zxc2012/NXP_Creative/README.md

### 智能车竞赛软件&&硬件开源
纪念那些ctrl+c/v的日子

quridor框架：minimax+alpha-beta prouning(java)

控制:双K60FX
