zxc2012/NXP_Creative/F题 纸张计数显示装置 余晨阳 田泽豪 王宇丰.pdf

# 全国大学生电子设计竞赛设计报告

## 选 题： F 题 纸张计数显示装置

摘要

本系统以 STM32F407 单片机为控制核心，结合电容传感器检测电路、显示电路、键盘

输入电路和蜂鸣器电路，实现了对两极板间的纸张数量进行计数并显示的功能。主控单元

通过 IIC 接口循环读取 FDC2214 的转换值；键盘输入电路将实时数据存储到单片机中，

利用最小二乘法拟合曲线，然后通过比较来检测当前的纸张数。经过实验与调试，系统成

功实现了题目所有的要求，且训练时间短，自适应能力强。整个装置采用直线滑轨结构，

稳定性好、精度高、功耗低，具有较高的性能指标。
关键词：STM32 单片机；FDC2214 传感器；最小二乘法；直线滑轨结构

## 1 方案分析与比较

## 1.1 主控芯片的选择

方案一：使用 8 位的 STC89C52 单片机，操作简单，使用方便，但中断资源较少，时

钟频率较低，处理速度较慢，实时性不高。

方案二：采用 32 位的 STM32F407 单片机作为控制芯片，芯片时钟频率高达 168MHz，

处理运算能力较强，且外设资源十分丰富。

综合考虑以上方案，由于本系统需要快速测量出电容，并计算出纸张数目，此过程中

涉及较多浮点运算，所以对单片机实时性和浮点运算能力有较高要求，此外单片机需要具

有 I2C 接口来连接 FDC2214 模块，还要使用 SPI 接口来连接显示模块，STM32F407 单片

机的资源更加丰富，故选择方案二。

## 1.2 测量传感器模块选择

方案一：NXP 公司生产的 PCA8885 电容式传感器。两极板间距离的变化带来电容的

变化，然后传感器将其转变为电信号。它具有自校准功能，性能受污垢、湿度等因素影响

较小。

方案二：TI 公司生产的 FDC2214 电容式传感器。FDC2214 分辨率高达 28 位，它还

具有多通道抗噪且抗 EMI 的特点。另外，TI 公司的 FDC2214 设计资源相当丰富，价格实

惠。

方案三：电涡流传感器。它通过电涡流效应的原理，准确测量被测体与探头端面的相

对位置，其特点是长期工作可靠性好、灵敏度高、抗干扰能力强。但是价格昂贵，且多面

向工业应用。

上述三种传感器均有较高的精度，可达到题目的要求，但是考虑到 FDC2214 芯片使用

更加方便，成本更低，所以最终采用方案二。

## 1.3 显示模块的选择

方案一：采用 LED 数码管显示。数码管使用简单，价格低廉，但一个数码管只能显

示一个数字，要显示多位数据时要使用多个数码管及译码器，增加了硬件电路的复杂度和

额外功耗，而且 LED 数码管也无法显示复杂字符，而本题需要展示相应的手势图片，所

以 LED 数码管不宜选用。

方案二：采用 OLED 液晶屏显示。OLED 重量轻，抗震性能好，响应时间短，显示

画面无拖影现象，显示内容丰富，驱动程序简单，可以实时显示文字及数据。

由于测试时需要自适应和功能切换等多个功能，采用 OLED 液晶屏显示能够更直观方

便，且便于调整，故选择方案二。

## 1.4 系统总体方案设计

本系统需要具备三个部分：数据采集部分、数据处理部分和输出部分。数据处理部分

选用 STM32 单片机作为主控芯片，来实现对各个其他模块的控制；数据采集部分选用

FDC2214 电容传感器模块，通过检测电容变化来判断纸张的数量；输出部分则采用显示模

块显示系统各个参数值以及纸张的数量。此外，通过按键来进行数据的确认和调整，通过

蜂鸣器来标志数据的存入。系统的总体方案原理图如图 1.1 所示。

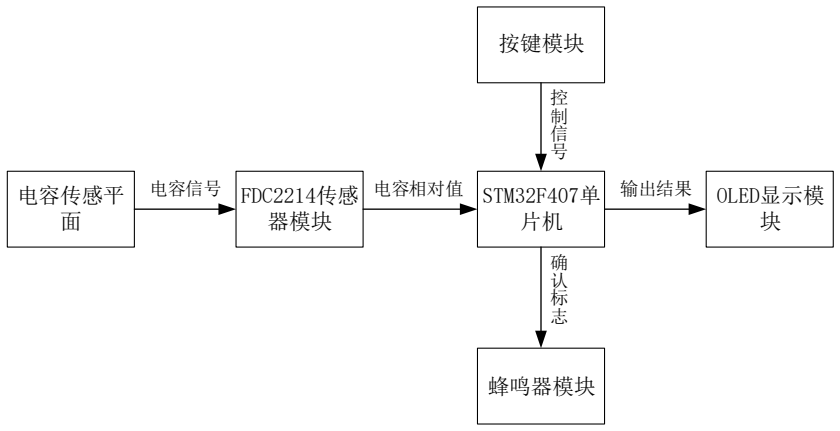
[picture p5: figure]
电容传感平 面; FDC2214传感 器模块; STM32F407单 片机; OLED显示模 块; 按键模块; 蜂鸣器模块; 电容信号; 电容相对值; 输出结果

图 1.1 系统总体框图

## 2 理论分析与计算

## 2.1 测量原理分析与计算

本系统采用 TI 公司出产的 FDC2214 电容传感器测量电容值，根据该电容值以及电容

定义式，即可得出两极板之间距离。传感器所得参数为
sensor

f

，即电容极板和电感所组成的

LC 谐振回路的谐振频率。根据 FDC2214 数据手册，可得：

28 2
sensor
x
REFx

f
DATA
f

·
=
(2.1)

其中 DATAx 为第 x 通道传感器读数，
sensor

f

为电容极板和电感所组成的 LC 谐振回路
的谐振频率，有：

1
2

sensor

f
π LC

=
(2.2)

其中，L 为电路中的固定电感，C 为总电容。

设 C0 为 FDC2214 电容传感器上的固定电容，CX为极板间的电容。根据式 2.1、2.2，

可以得出极板电容为：

56

0 | 0 2 | 2 | 2

2
4

X
x | REFx
C | C C | C
π L DATA | f
= - | = | -
× | ·
(2.3)

由电容定义式

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
(2.4)

可得出极板间距 d 与传感器读数之间的关系为：

| | 2 | 2
0
56 | 2 | 2 | 2
0
(2 | 4 | )
r | x | REFx
x | REFx
S L DATA | f d
k | L DATA | f | C

ε ε π
π
| | | | × | | | | ×
=
- | × | × | ×
(2.5)

根据式(2.5)可以看出，在其它变量保持一定时，极板间电容的大小 C 与极板间距 d 程 反比关系。若将电容值取倒数，可得厚度函数
| | | | f

与纸张数成正相关关系。

## 2.2 误差分析与抗干扰分析

对给定数据点集合{(Xi ,yi)}(i=0,1,2,…,m)，在取定的函数类 φ

中，求
p(X)Îφ

，使误差

的平方和

2 E
最小，有：
2 | 2 [ ( | ) | ] E | p X | y = | - ∑ | i | i
(2.6)

我们利用 SPSS 软件对电容的倒数(厚度函数)进行回归分析，得到拟合曲线结果和相关

系数结果如图 2.1 和表 2.1 所示。

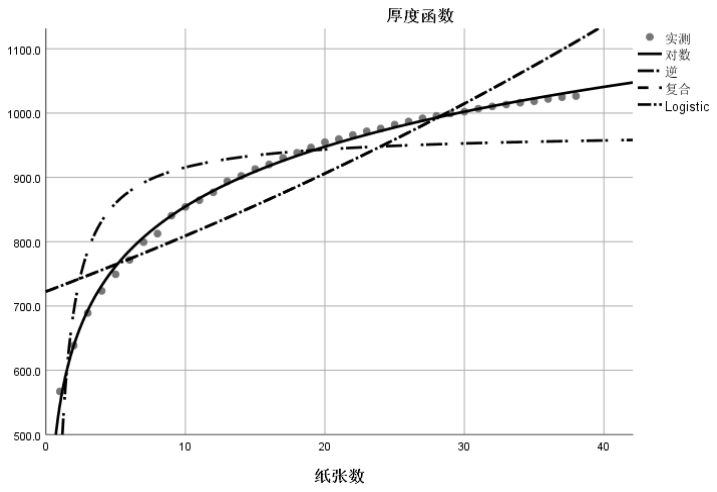
[picture p6: figure]

图 2.1 电容值的倒数随纸张变化曲线拟合图像

表 2.1 四种函数拟合统计分析结果

函数类型 | 2 R | F
对数 | 0.997 | 11401.412
逆 | 0.706 | 86.522
复合 | 0.780 | 127.600
S | 0.775 | 124.040

由图 2.1 和表 2.1 可知，对数函数拟合我们的厚度函数效果最好，回归参数

2 R
可达

0.997。

对于本系统的抗干扰性，系统受到的干扰来源于机械结构的松动造成的极板正对面积

的变化以及外界信号干扰造成的电容测量变化。对于机械松动，可以使用滑轨与滑块作为

极板的活动支撑，由于滑轨可以约束滑块只朝平行于导轨方向运动，可以在很大程度上防

止极板左右移动，保证了正对面积的恒定。对于外界信号干扰，可在极板到传感器的连接

上使用 SMA 线，并对采集到的原始数据进行限幅平滑滤波，以减小误差、提高抗干扰性。

## 3 硬件及程序设计

## 3.1 电路设计

MCU 外围电路包括复位电路、JTAG 调试电路、时钟电路等等。具体电路见附录 2。

测量传感器电路主要由四通道 FDC2214 电容传感器芯片，外部 40M 有源晶振电路，

抗 EMI 电磁干扰电路组成。其中 FDC2214 芯片通过 I

2C 接口与 STM32 单片机通信实现

FDC2214 寄存器配置以及 STM32 数据读取。将两极板分别接上 FDC2214 模块一个通道的

两个端口上连上极板的两个端口。此外，为了防止感应板与 FDC2214 芯片的引线过长产生

EMI，电路中设计了抗电磁干扰电路，提高了系统稳定性。

## 3.2 机械结构设计

本设计的机械结构是以滑轨和滑块为主体搭建的。其中最上方和最下方的滑块为固定

滑块，用来代表移动边界，中间的滑块为移动滑块，且与滑轨连接光滑。两极板分别固定

在中间滑块和下方滑块上，纸张放置在极板之间，这样将中间滑块与下方滑块贴合就可以

测量纸张的数目了。此外我们设计了一个底座来固定滑块和滑轨，使系统具有更高的稳定

性和抗干扰性。

此机械结构能够保证两极板间接触面积恒定，且能够保证与纸张完全压紧，更换纸张

数目也很简便，具有较高可行性和精确性。系统机械结构如图 3.1 所示。

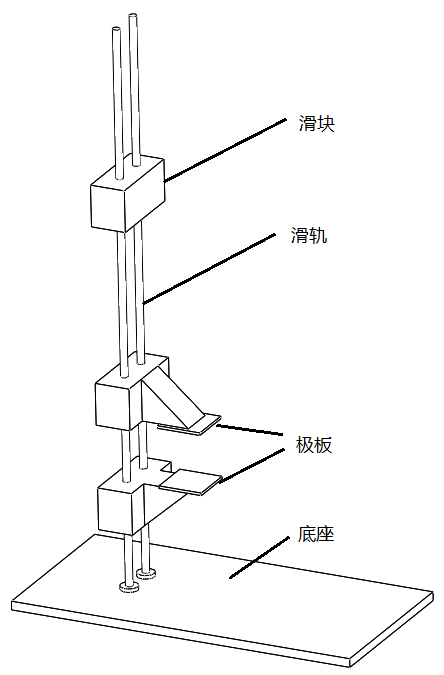
[picture p7: figure]

图 3.1 系统机械结构设计图

## 3.3 软件设计

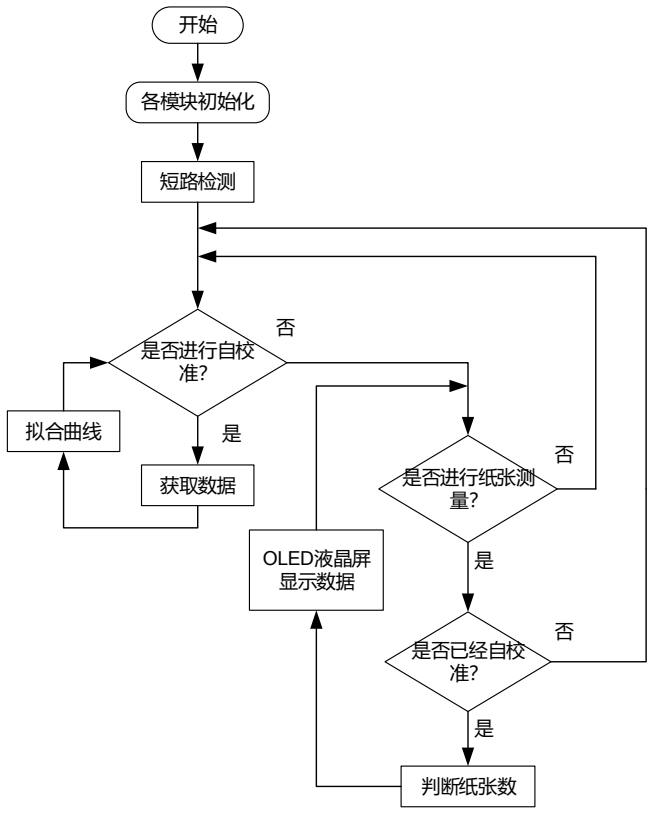
[picture p8: figure]
各模块初始化; 是否进行自校 准？; 短路检测; 获取数据; 拟合曲线; 是否进行纸张测 量？; 是否已经自校 准？; 判断纸张数; OLED液晶屏 显示数据

图 A 主程序框图 | 图 B 学习模式框图

图 3.2 系统运行整体流程

系统程序框图如图 3.2 所示，分别为系统主程序与学习子程序。系统初始化后，首先 初始化各个模块，随后判断极板的短路情况，然后选择功能。若进入自校准模式，则采集 多组数据进行拟合，得到纸张数目随传感器测量值的变化曲线，然后返回到任务选择部分。 如果再选择测量纸张模式，则首先会判断是否已自校准，如果已经校准，则利用计算的拟 合曲线对传感器输入量进行判定，得出纸张数量，如果还没有校准，就不进入测量模式， 而是继续选择任务。

其中在学习模式下，首先抽取不同数量的纸张，在单片机中存储不同数量纸张对应的

测量值，对该值进行函数拟合，即可得到一条纸张数与测量值之间的函数曲线。由于误差

的存在，计算出的纸张数通常为小数，此时可以将该值分别向上和向下取整，比较测量值

与两个计算出的值的接近程度，选择更接近的传感器数值对应的纸张数目，即可判定纸张

数目。

## 4 测试数据与结果分析

（1）基础部分：

经过测试，该系统能够存储不同纸张对应的测量数据，并计算出拟合函数的待定系数，

具有自校准功能。且在两极板短路时会产生提示，具有短路自检功能。

在纸张数目为 1~10 中任意抽取几组数据进行测试，得到结果如表 4.1 所示。

表 4.1 纸张数为 1 至 10 张时测试记录表

次数 | 实际数目 N0 | 测量数目 N | 数目偏差|N-N0| | 测量时间 t/s
1 | 1 | 1 | 0 | 0.04
2 | 4 | 4 | 0 | 0.04
3 | 5 | 5 | 0 | 0.01
4 | 9 | 9 | 0 | 0.05
5 | 10 | 10 | 0 | 0.03
从表中可以看出，当纸张数目为 1~10 时，该系统能够精准的测出极板间纸张的数目，

且用时较少，满足题目要求。

（2）发挥部分：

在纸张数目为 15~30 和 30 以上中任意抽取几组数据进行测试，得到结果如表 4.2 所

示。

表 4.2 纸张数目为 15 至 30 和 30 以上时测试记录表

次 数 | 纸张数为 15 至 30 张 | 纸张数大于 30 张
实际数目 | 测量数目 | 测量时间 t/s | 实际数目 | 测量数目 | 测量时间 t/s
1 | 15 | 15 | 0.03 | 30 | 30 | 0.03
2 | 18 | 18 | 0.03 | 33 | 33 | 0.03
3 | 20 | 20 | 0.01 | 35 | 35 | 0.01
4 | 24 | 24 | 0.06 | 38 | 38 | 0.06
5 | 28 | 28 | 0.02 | 40 | 40 | 0.02
6 | 30 | 30 | 0.05 | 41 | 40 | 0.05
从表中可以看出，当纸张数目为 15~30 时，该系统能够精准的测出极板间纸张的数目，

且用时较少，满足题目要求。

当纸张数目为 30~40 时，该系统能够精准的测出极板间纸张的数目，且用时较少，满

足题目要求。但当纸张数目大于 40 后，系统无法正确测量出纸张的数目。

通过上述测试结果，可以看出，该系统能够精确测试出纸张数目为 1~40 时的纸张数

量，且用时较短，满足题目的全部基本要求和发挥部分的第一问。发挥部分第二问中，当

纸张数目过大时，受电容传感器分辨率的影响，而此时的电容值非常接近，故测量出现一

定偏差。综合测试结果，该系统纸张数目最多可以测量到 40 张，且具有自校验和检测短路

的功能。

5 小结

通过系统测试，本系统成功实现了纸张计数的功能。在通过自校准后，可以快速稳定 识别 38 张以内的纸张数目，并可以蜂鸣提示及在 OLED 屏幕中显示，实现了题目中的基 本要求和发挥要求。同时，在识别过程中，还可实时检测极板短路情况，并给出提示。在 测量纸张数大于 35 张时，发现传感器数据间隔越来越小，分辨力降低。但是我们采用加固 机械结构、使用屏蔽线等措施，大大提高了信噪比，使得在纸张数较多时，仍然能够分辨， 减少了误判的可能性。在比赛中，我们遇到了很多困难，但是最终我们解决了各种问题， 成功实现了题目的各项要求。

## 附录：各模块电路图

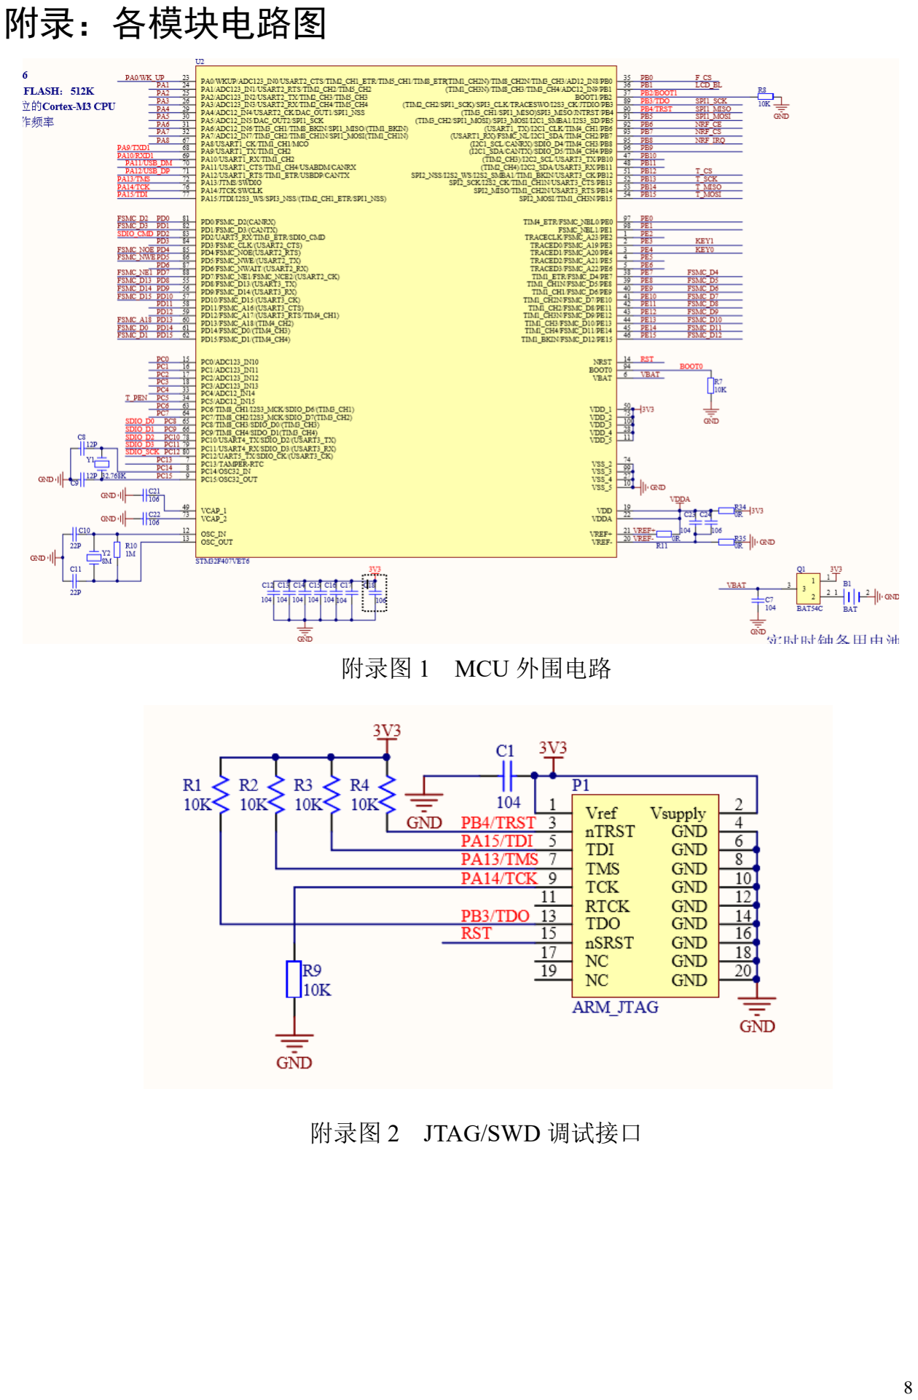
[picture p9: page 10]

附录图 1 MCU 外围电路

附录图 2 JTAG/SWD 调试接口

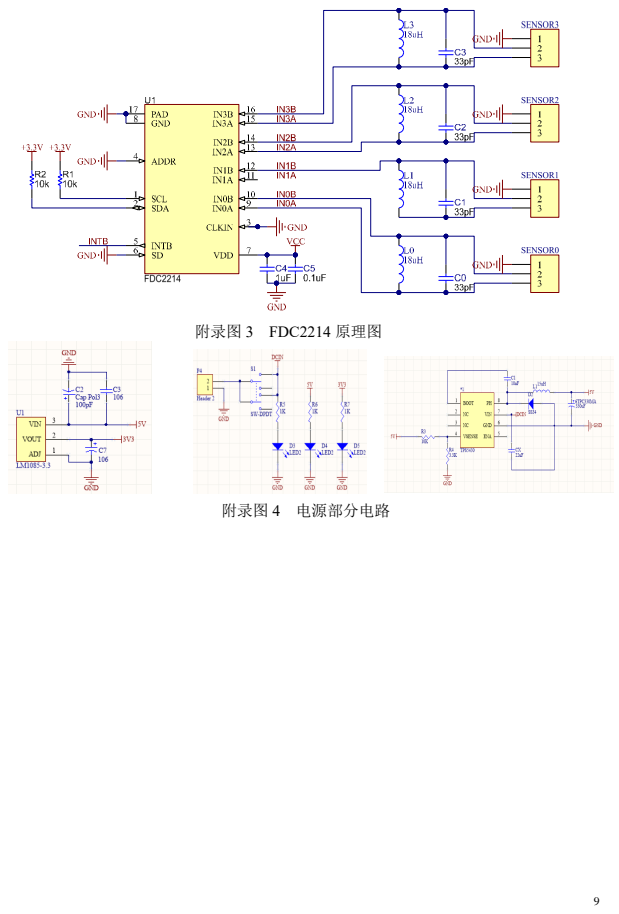
[picture p10: page 11]
附录图 3 FDC2214 原理图; 附录图 4 电源部分电路
