zxc2012/NXP_Creative/Cylinder/readme.md

# 要求

- 随机生成函数RandomArray（int n, int max）:随机生成一个一维整数数组，数组长度为n，元素值不超过max
- 判断函数CheckOrder（）：判断数组中元素是否按升序排练，若是返回1，否返回0
- 数组和函数Sum（）：计算数组和
- 判断某个元素函数CheckKey（）：找到数组中的某个值（key），若有返回1，无返回0
- 编写main函数，调用测试以上功能
