zxc2012/NXP_Creative/参赛承诺书.pdf

# 第十四届全国大学生“恩智浦”杯 智能汽车竞赛参赛承诺书

我们参加第十四届全国大学生“恩智浦”杯智能汽车竞赛，通过报名获得参

赛资格，同意并承诺：

1. 阅读、理解并接受第 14 届全国大学生“恩智浦”杯智能汽车竞赛比赛规则；
2. 遵守组委会制定的规章制度，按照组委会要求提供详细，准确的报名信息；

独立完成赛车设计、开发、调试工作，并接受组委会检查；

3. 按照规定提交符合规范的设计技术文档；同意竞赛秘书处和恩智浦公司在其

相关主页及文献中收录并公开获奖作品的设计方案、技术报告及参赛模型车

的视频、图像资料；

4. 按时参加比赛；参赛过程中，我们承诺遵守大赛规则、公平竞争。
5. 承诺在比赛期间言行、举止文明合法，注意交通安全、不到任何公共水域游

泳，对自己的人身安全负责。

大学名称： 武汉理工大学

(盖章)

参赛队伍名称： 996.icu

带队教师代表签字：

队员签字：

日期：
