zxc2012/NXP_Creative/硬件/RT1062/原理图.pdf

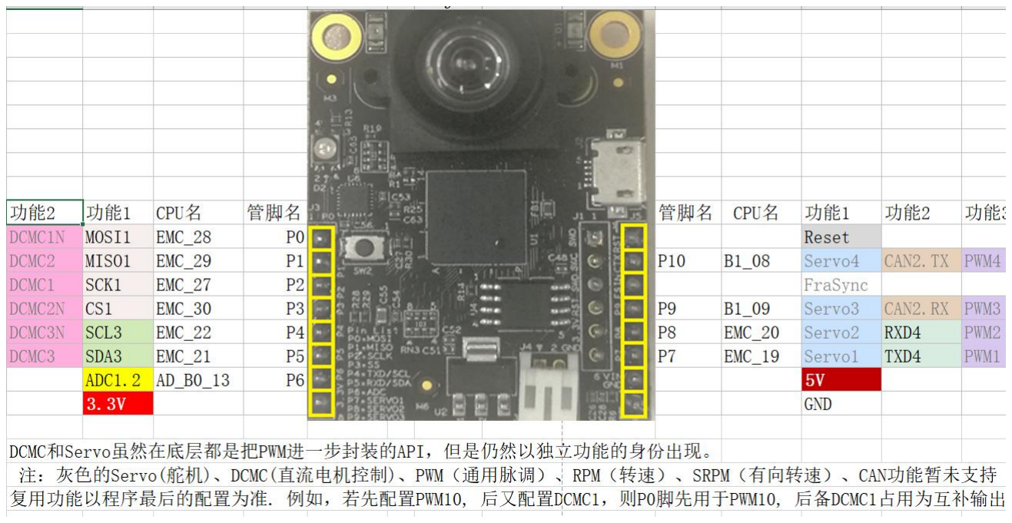
[picture p54: figure]
