zxc2012/NXP_Creative/硬件/Control board/八路btn驱动.pdf

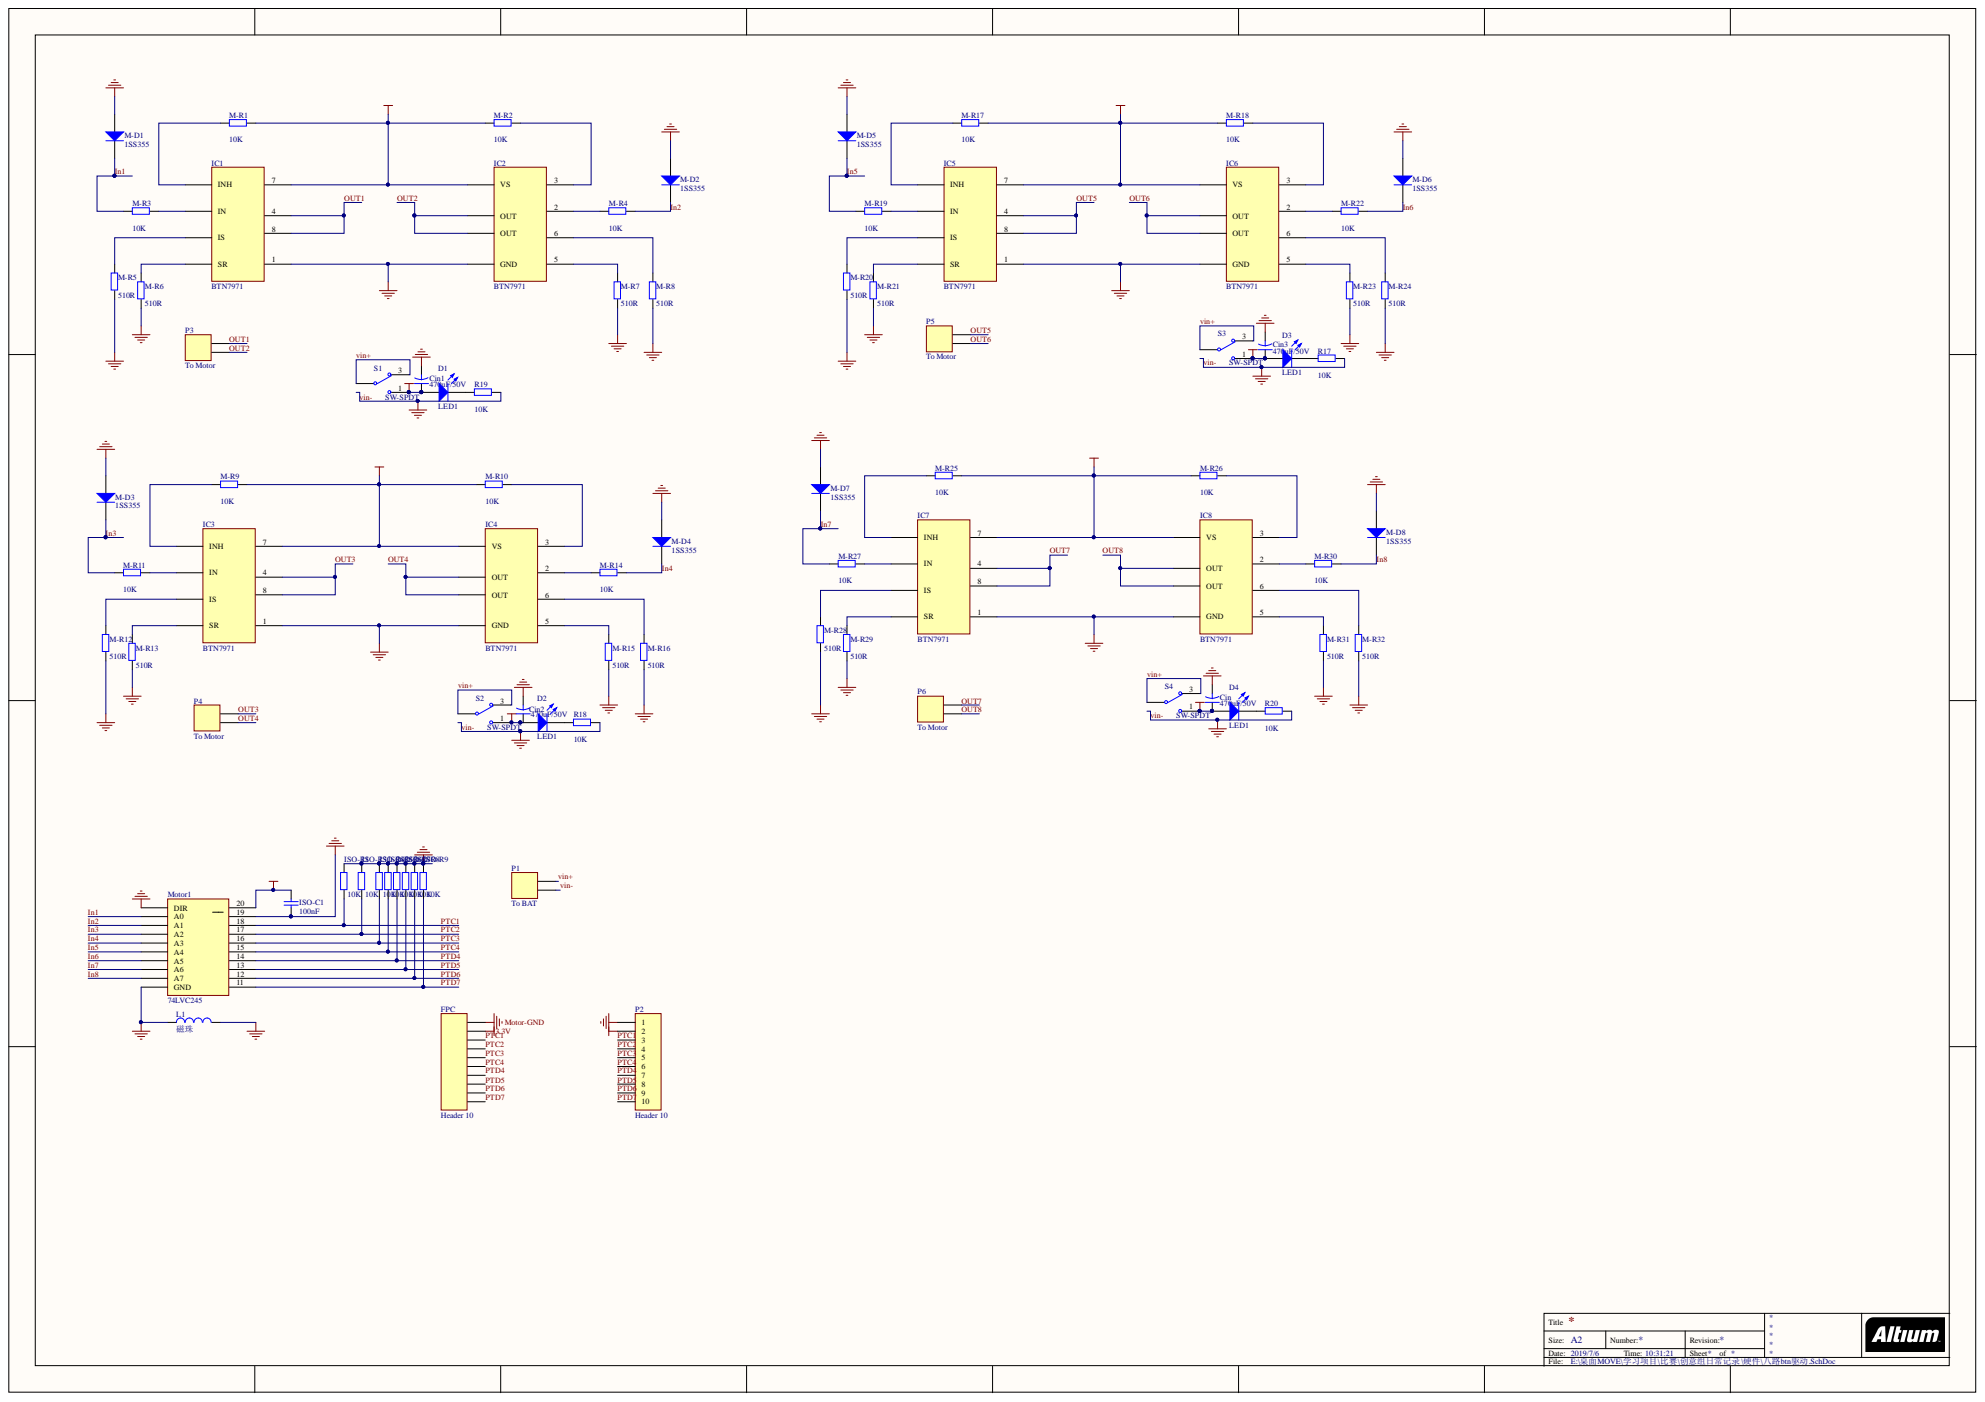
[picture p55: page 1]

SW-SPDT Motor-GND

* Title | * * * * *

Size: A2 | Number: * | Revision: *

Date: 2019/7/6 Time: 10:31:21 | | Sheet * of *

E:\桌面MOVE\学习项目\比赛\创意组日常记录 \硬件\八路btn驱动.SchDoc
