zxc2012/NXP_Creative/硬件/Control board/创意F1.pdf

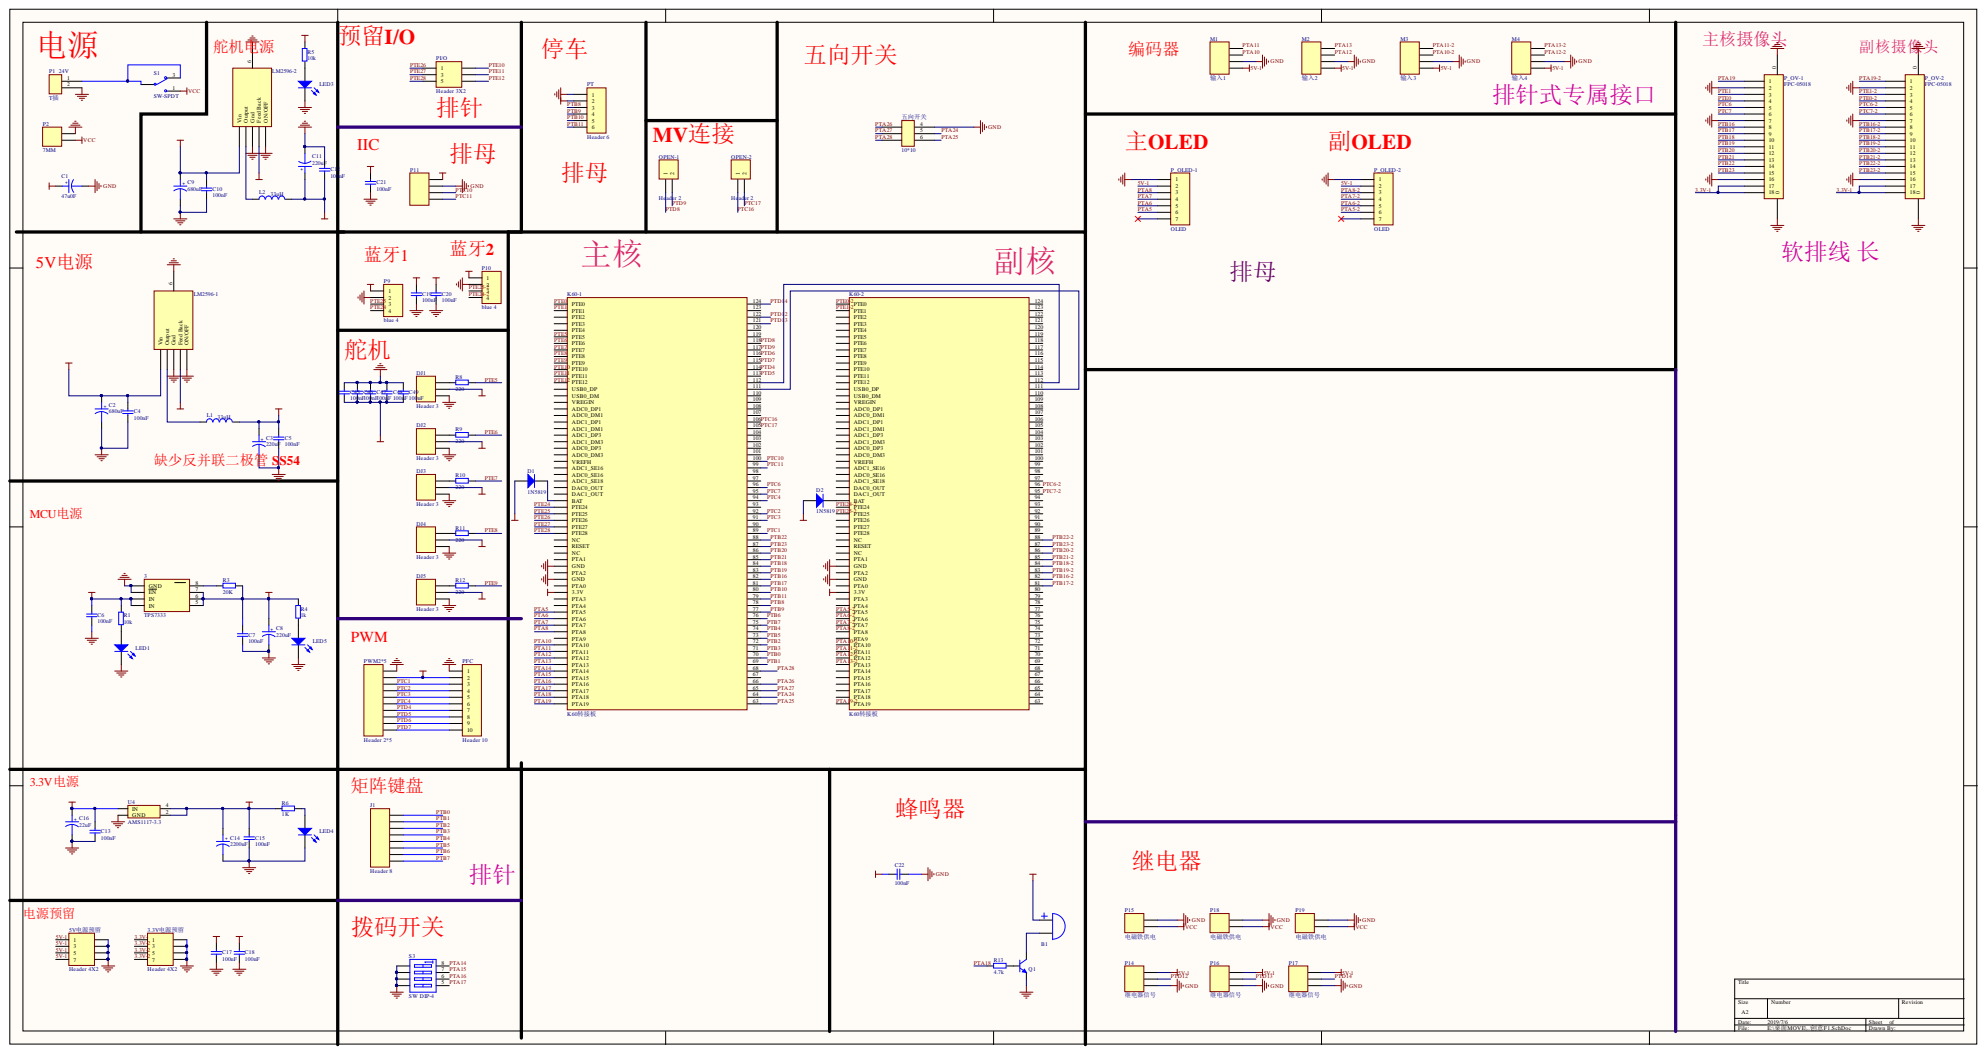
[picture p56: page 1]

PWM PWM2*5 PFC | PTA7 PTA8

Size A2 | Number | Revision

Date: 2019/7/6 | Sheet of
File: E:\桌面MOVE\..\创意F1.SchDoc | Drawn By:
