zxc2012/NXP_Creative/(list of files, drawings)

Other design files:
硬件/Control board/PCB_Project.PrjPcb
硬件/Control board/八路btn驱动.SchDoc
硬件/Control board/创意F1.SchDoc
